ultrazohm/uz_a_max11331/Project Outputs for UZ_A_MAX11331/Rev03/DOC/UZ_A_MAX11331_3D_View_Bird_Rev03.png

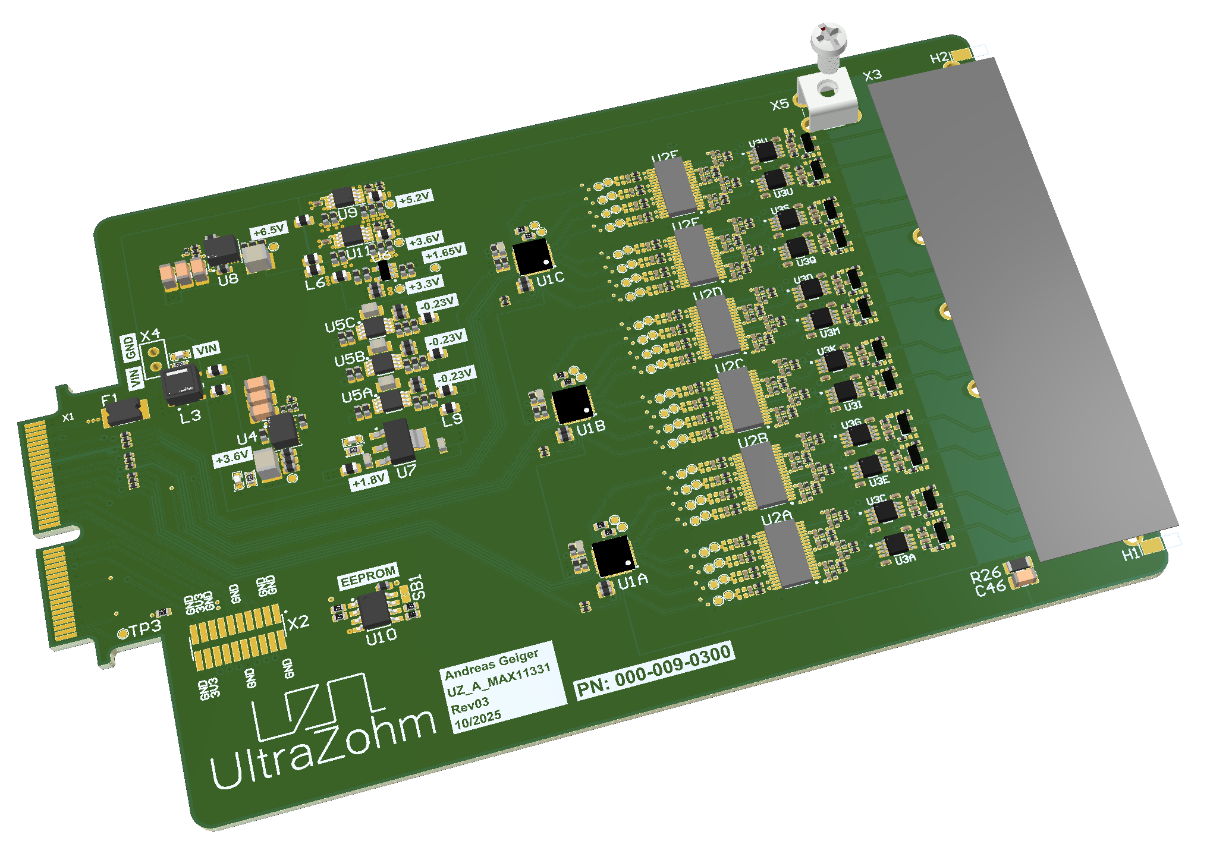
Project Outputs for UZ_A_MAX11331/Rev03/DOC/UZ_A_MAX11331_3D_View_Bird_Rev03.png
