ultrazohm/uz_a_max11331/Work_LTspice/Boost_and_Diff_OpAmp/MAX11331_Rev03_OpAmp_SupplyCurrentSimulation.png

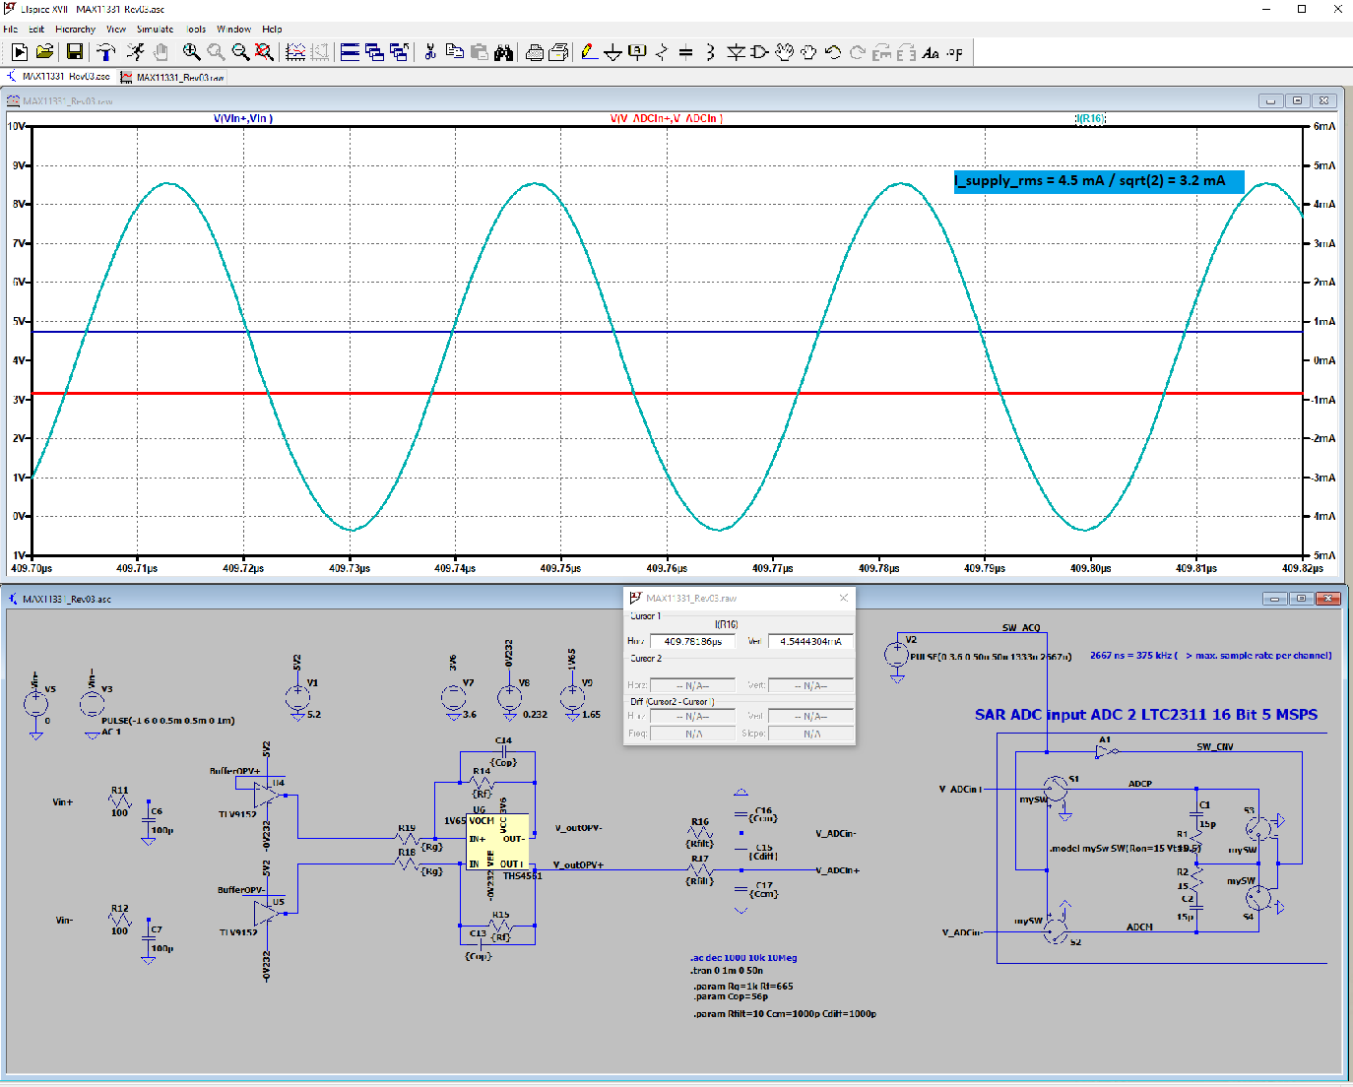
Work_LTspice/Boost_and_Diff_OpAmp/MAX11331_Rev03_OpAmp_SupplyCurrentSimulation.png
