ultrazohm/uz_a_max11331/Project Outputs for UZ_A_MAX11331/Rev03/MAX1131_V3_Evaluation.xlsx

MAX11 V3 ADC Evaluation (Alle Messungen in [V]) |  |  |  | ConversionFactor ADC auf Basis von OpAMp Schaltung im Analog-FrondEnd:
 |  |  |  |  | 4.962406015
 |  |  |  | Nutzbarer Spannungsbereich (alles was größer ist im Betrag, wird nicht mehr gemessen)
 |  |  |  |  | -4,957V…+4,957V
 |  |  |  |  |  | [V] |  |  | [A] | [A] | [A]
Extern _P | Extern _N | Extern Delta | ADC01 | ADC09 | ADC17 | Fehler von ADC01 | Fehler von ADC09 | Fehler von ADC17 | ADC01:Wenn 5V=600A wären | ADC09:Wenn 5V=600A wären | ADC17:Wenn 5V=600A wären
0 | 4.955 | -4.955 | -4.957 | -4.959987 | -4.96241 | 0.002 | 0.004987 | 0.00741 | 0.24 | 0.60 | 0.89
0 | 4.755 | -4.755 | -4.761 | -4.758873 | -4.76372 | 0.006 | 0.003873 | 0.00872 | 0.72 | 0.46 | 1.05
0 | 4.455 | -4.455 | -4.458 | -4.455992 | -4.463261 | 0.003 | 0.000992 | 0.008261 | 0.36 | 0.12 | 0.99
0 | 4.055 | -4.055 | -4.061 | -4.056189 | -4.061035 | 0.006 | 0.001189 | 0.006035 | 0.72 | 0.14 | 0.72
0 | 3.957 | -3.957 | -3.961 | -3.954421 | -3.964113 | 0.004 | -0.002579 | 0.007113 | 0.48 | -0.31 | 0.85
0 | 2.957 | -2.957 | -2.961 | -2.958546 | -2.960969 | 0.004 | 0.001546 | 0.003969 | 0.48 | 0.19 | 0.48
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
