ultrazohm/uz_a_max11331/Project Outputs for UZ_A_MAX11331/Rev01/ASM_UZ_A_MAX11331_Differential_Input_Rev01.PDF

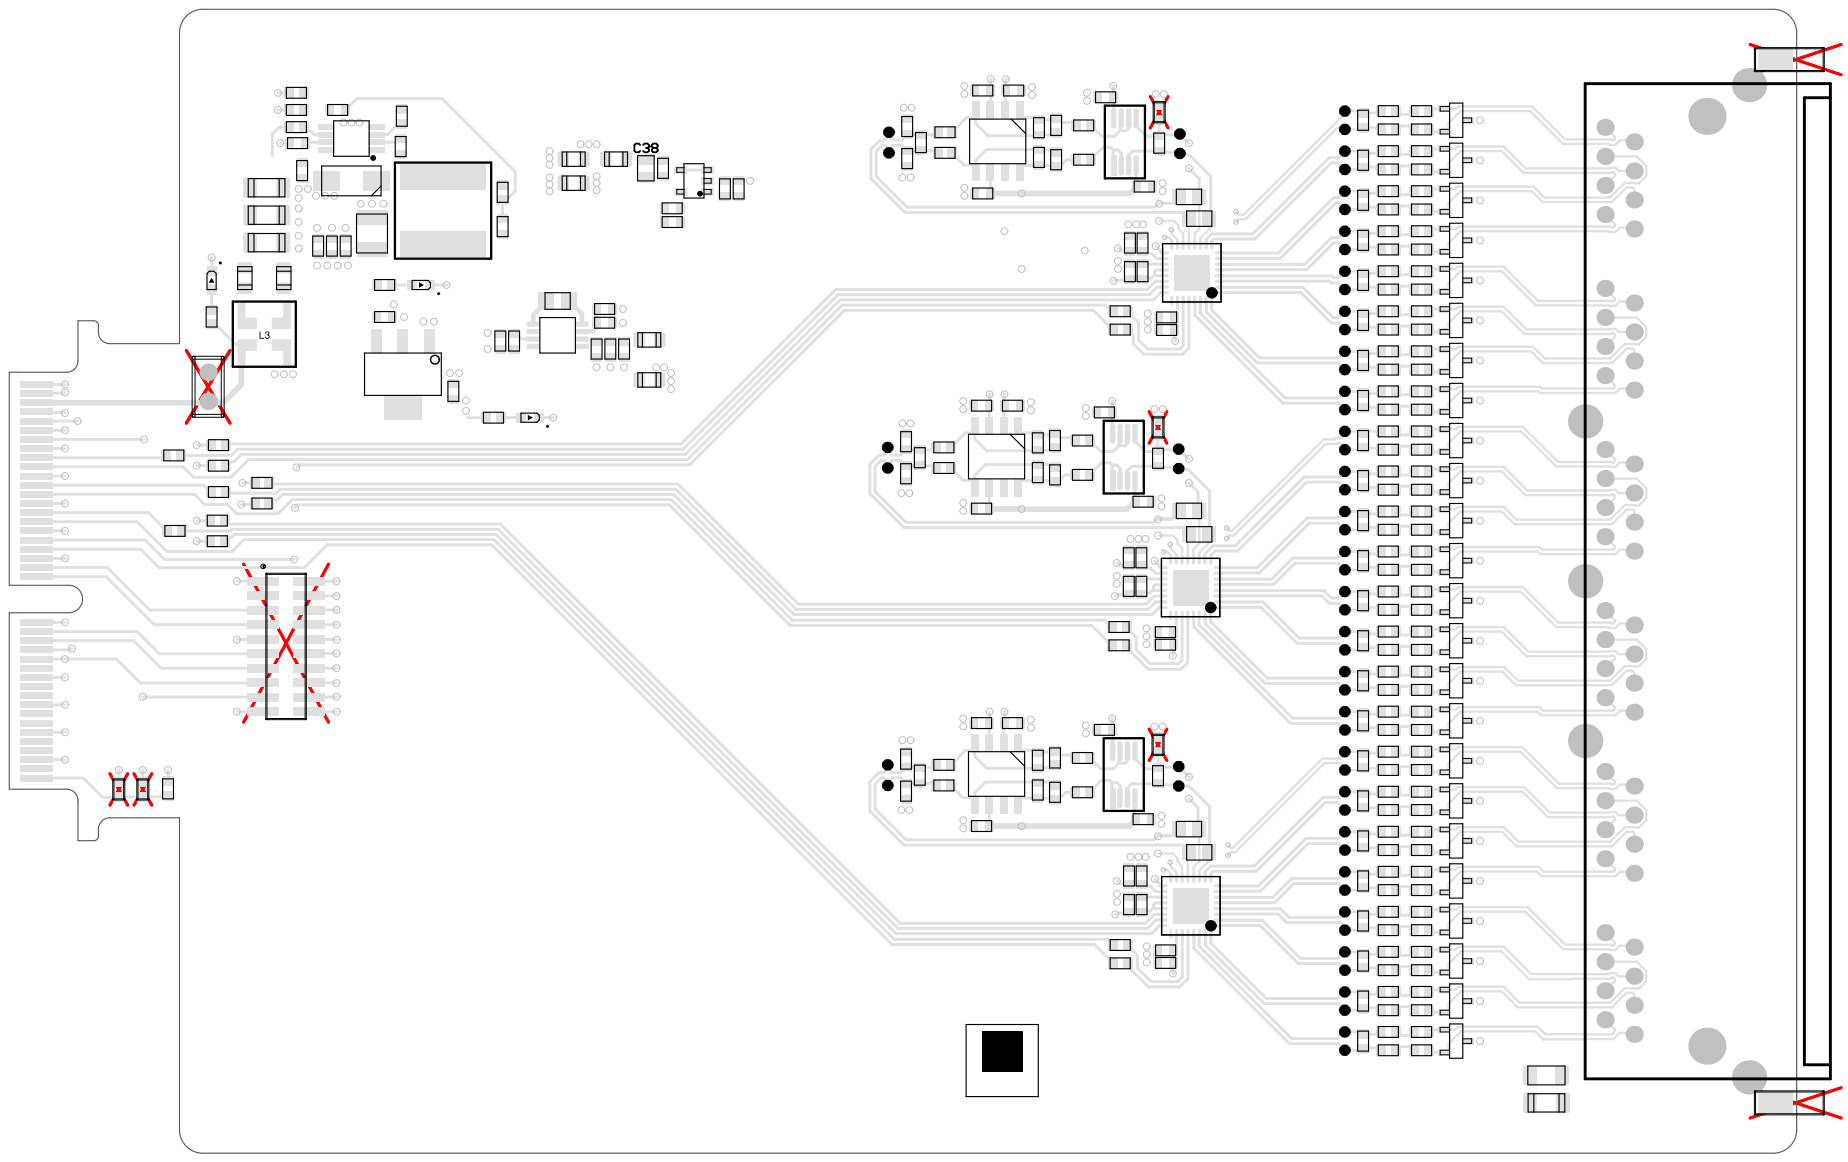
[picture p5: page 1]

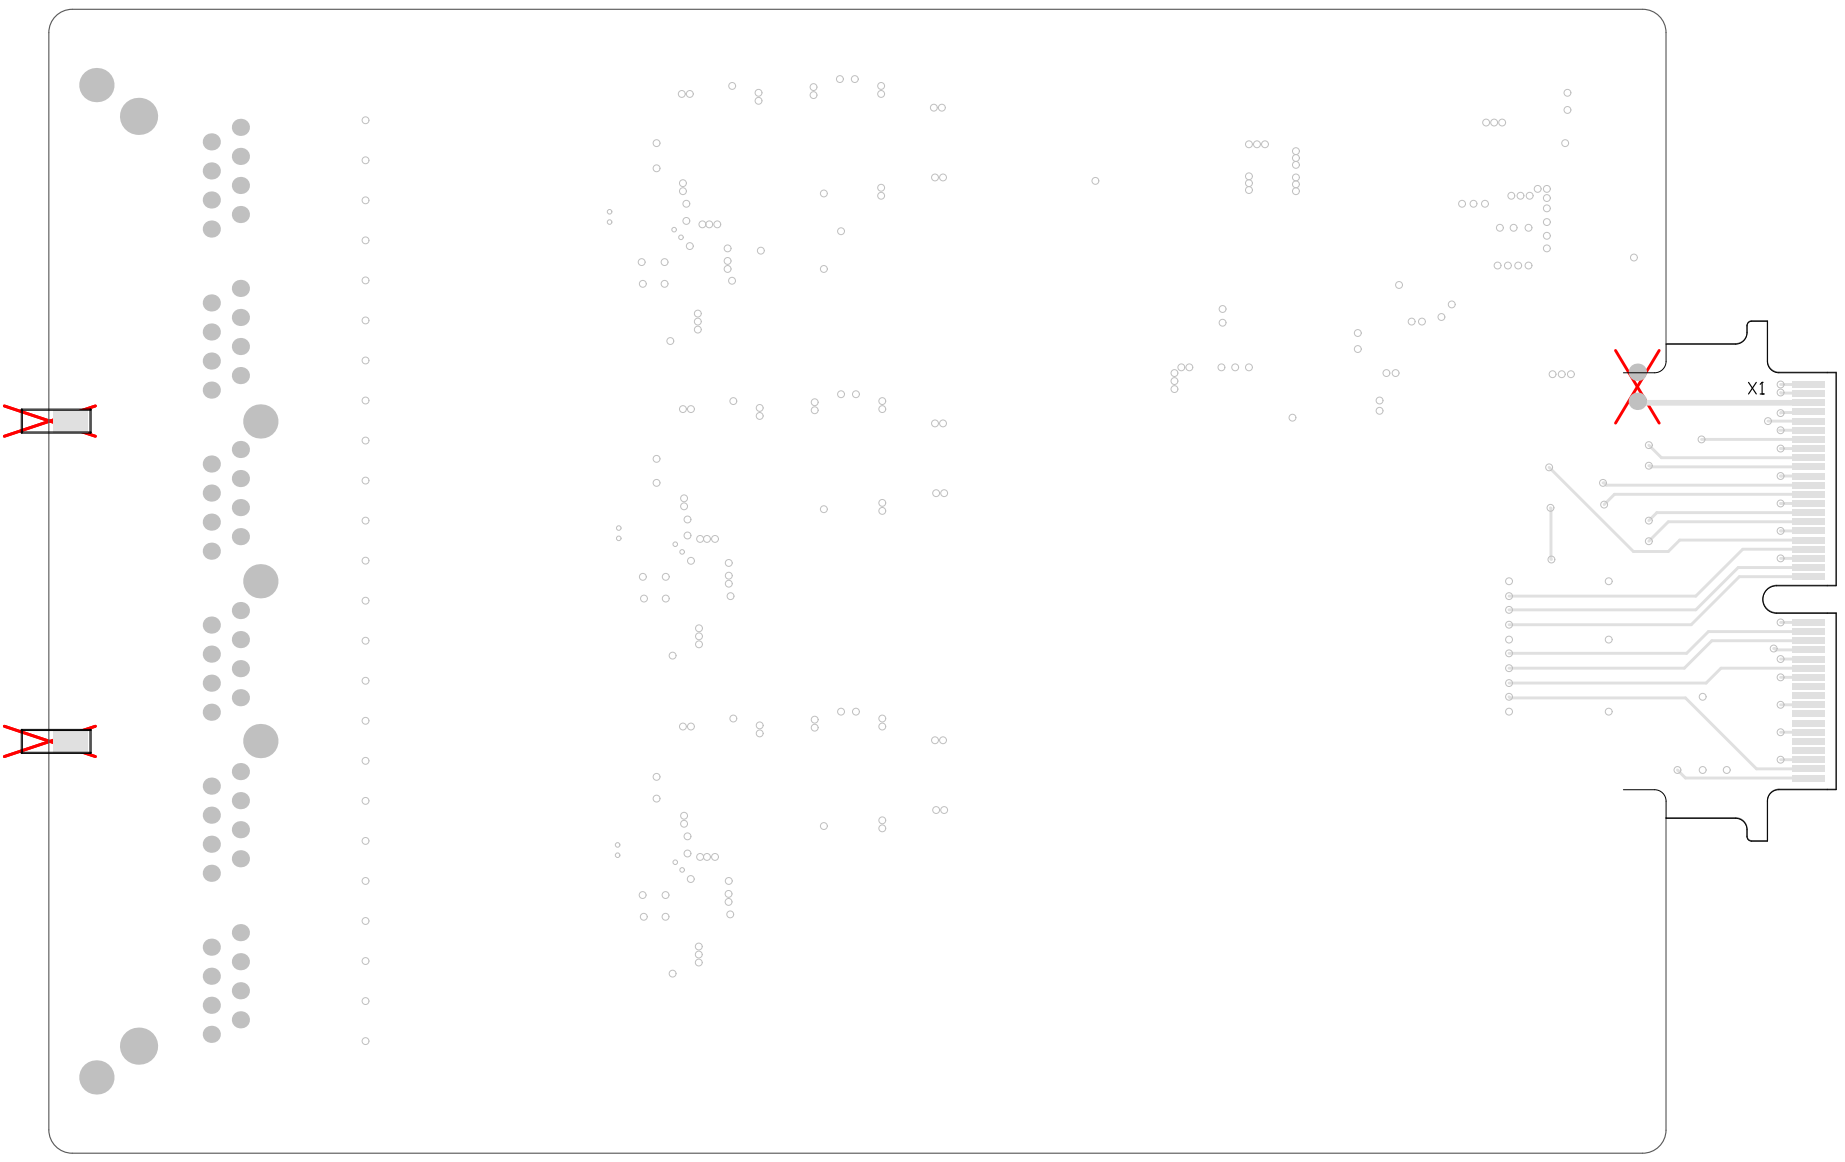
[picture p6: page 2]
