ultrazohm/uz_a_max11331/Project Outputs for UZ_A_MAX11331/Rev02/DOC/UZ_A_MAX11331_3D_View_Bird_Rev02.PDF

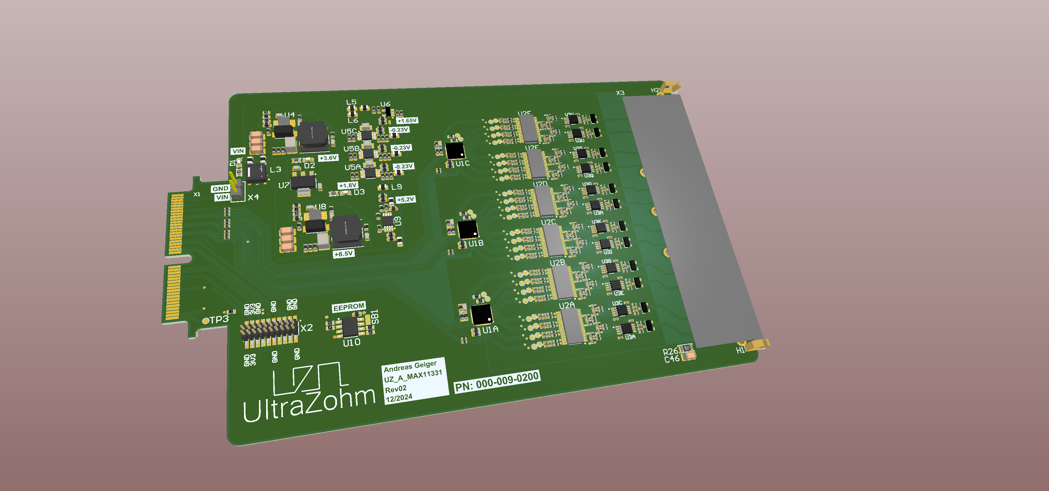
[picture p7: page 1]
