ultrazohm/uz_a_max11331/Project Outputs for UZ_A_MAX11331/Rev02/DOC/UZ_A_MAX11331_3D_View_Bot_Rev02.PDF

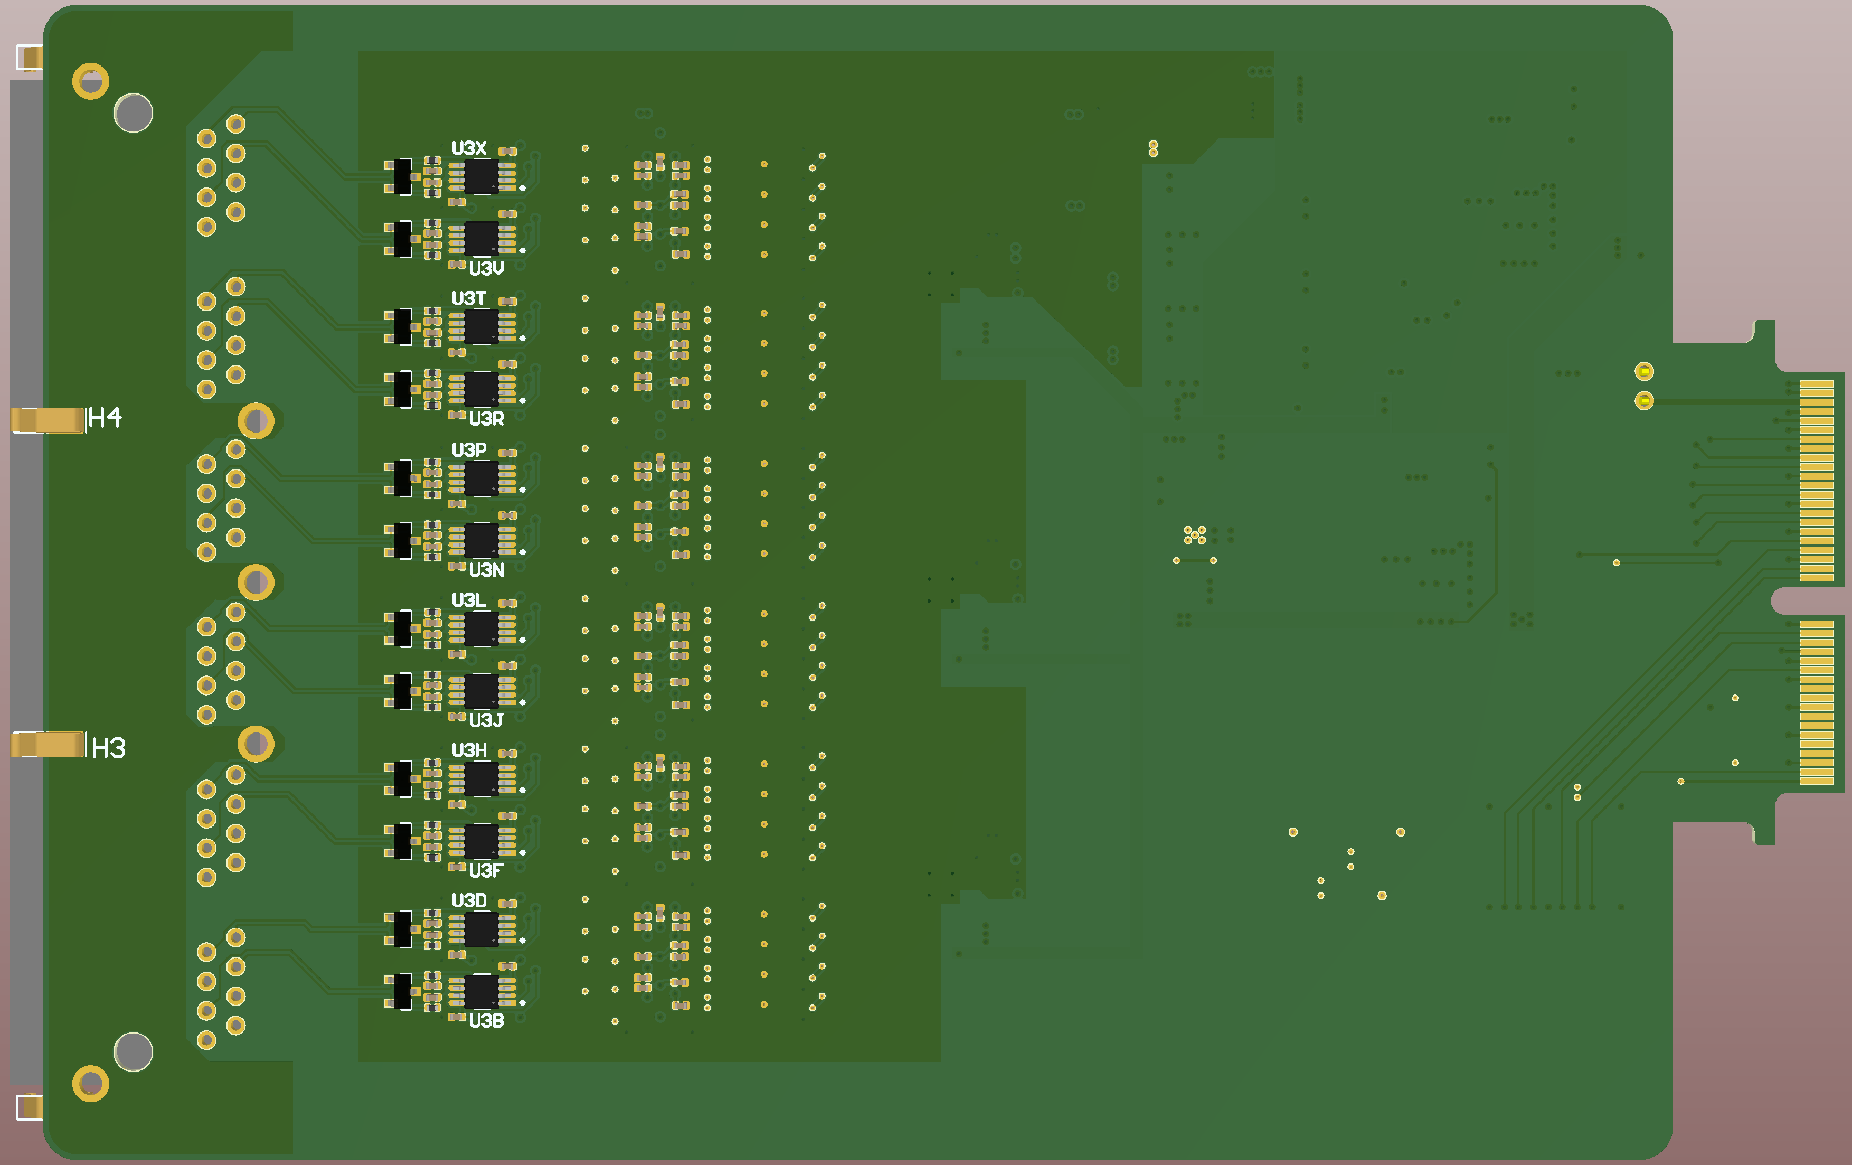
[picture p8: page 1]
