ultrazohm/uz_a_max11331/Project Outputs for UZ_A_MAX11331/Rev02/DOC/UZ_A_MAX11331_3D_View_Top_Rev02.PDF

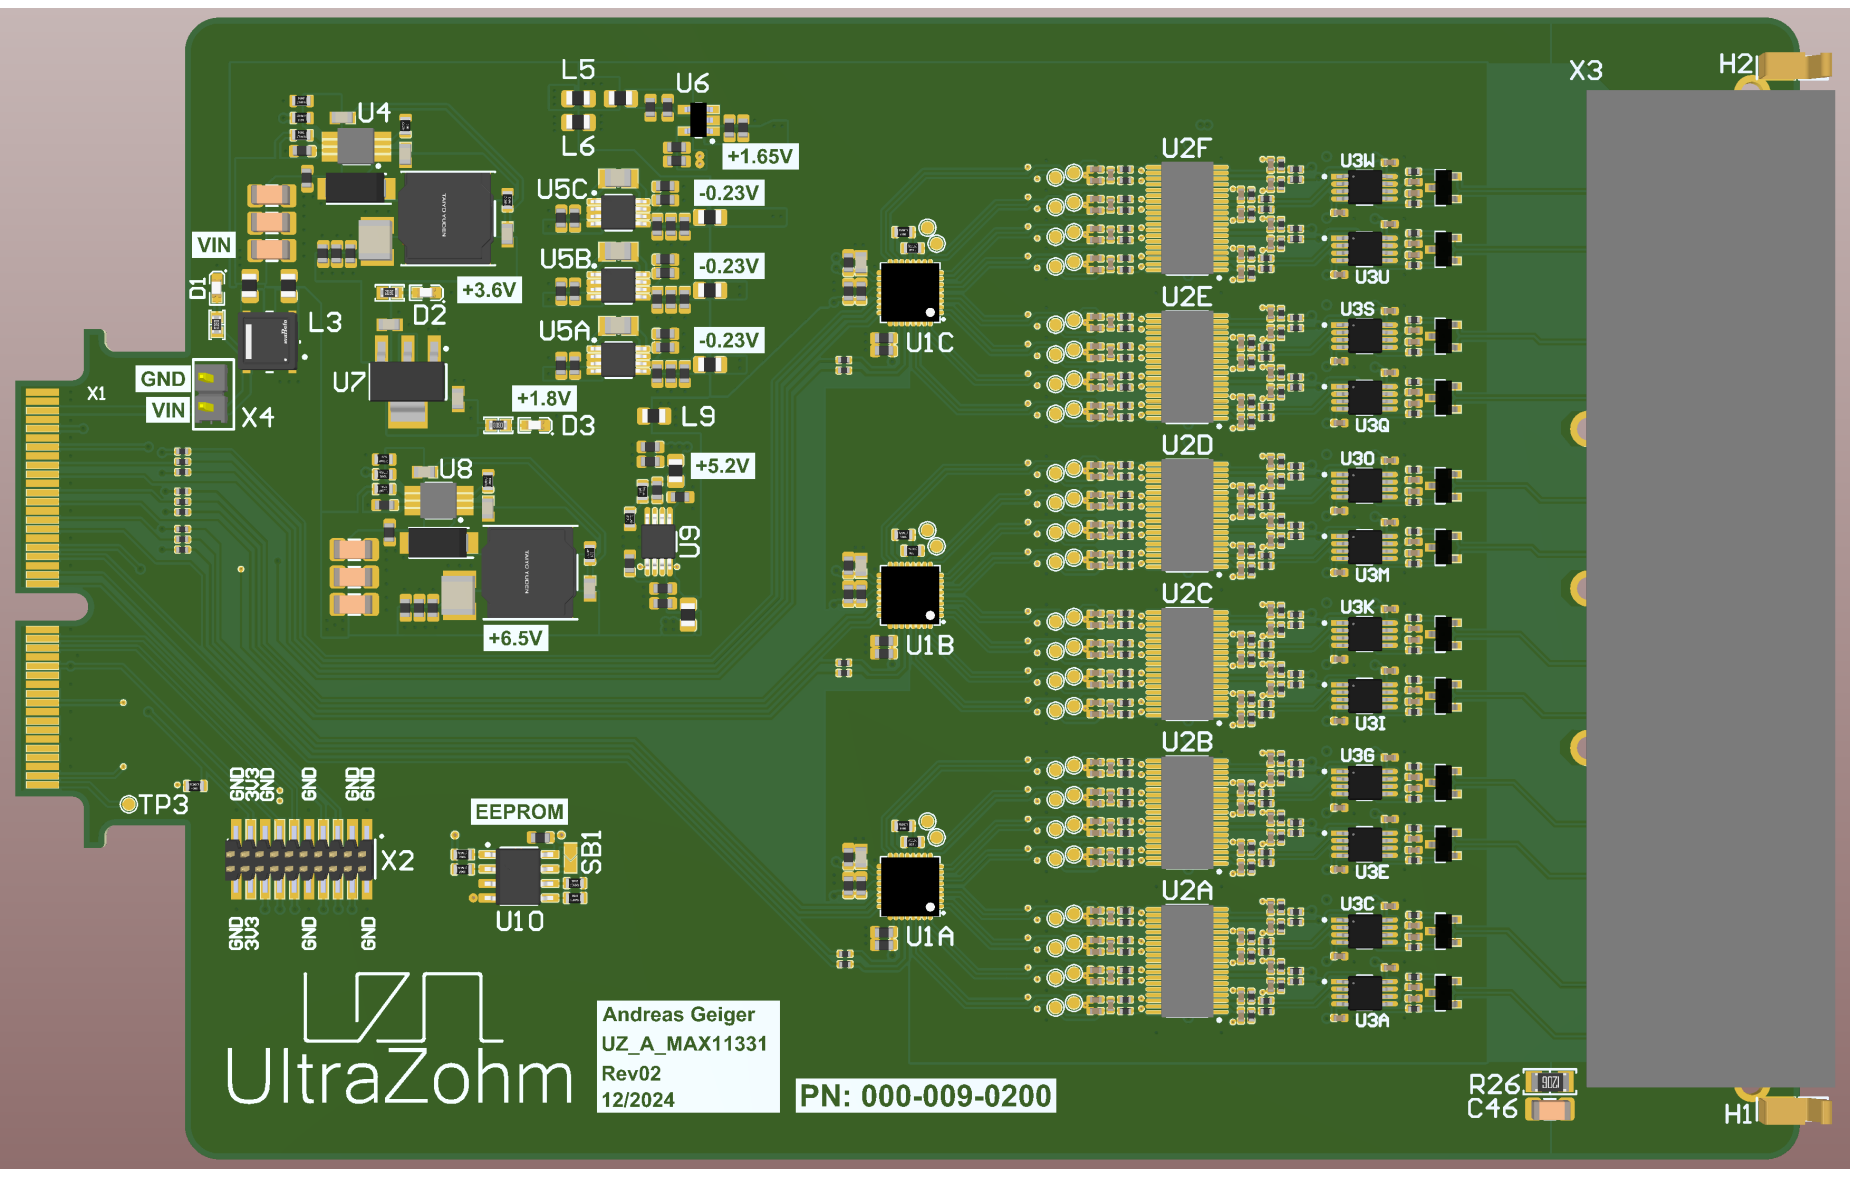
[picture p9: page 1]
