ultrazohm/uz_a_max11331/Work_LTspice/Boost_and_Diff_OpAmp/MAX11331_Rev03.asc

A1: inv
C1: cap; 15p
C2: cap; 15p
C6: cap; 100p
C7: cap; 100p
C13: cap; {Cop}
C14: cap; {Cop}
C15: cap; {Cdiff}
C16: cap; {Ccm}
C17: cap; {Ccm}
R1: res; 15
R2: res; 15
R11: res; 100
R12: res; 100
R14: res; {Rf}
R15: res; {Rf}
R16: res; {Rfilt}
R17: res; {Rfilt}
R18: res; {Rg}
R19: res; {Rg}
S1: sw; mySW
S2: sw; mySW
S3: sw; mySW
S4: sw; mySW
U4: TLV9152
U5: TLV9152
U6: THS4561
V1: voltage; 5.2
V2: voltage; PULSE(0 3.6 0 50n 50n 1333n 2667n)
V3: voltage; PULSE(-1 6 0 0.5m 0.5m 0 1m); AC 1
V5: voltage; 0
V7: voltage; 3.6
V8: voltage; -0.232
V9: voltage; 1.65
Named nets: 0, Vin+, Vin-, 3V6, -0V232, 5V2, V_outOPV+, V_outOPV-, 1V65, BufferOPV-, BufferOPV+, SW_ACQ, ADCP, ADCM, SW_CNV, V_ADCin+, V_ADCin-
.tran 0 1m 0 50n
.param Rg=1k Rf=665
.param Cop=56p
.ac dec 1000 10k 10Meg
.param Rfilt=10 Ccm=1000p Cdiff=1000p
.model mySw SW(Ron=15 Vt=0.5)
SAR ADC input ADC 2 LTC2311 16 Bit 5 MSPS
2667 ns = 375 kHz (--> max. sample rate per channel)
