ultrazohm/uz_a_max11331/Work_LTspice/AnalogLTC2311-16_with_THS4521/ADC_ShuntSensitec_MitSpannungsfolgerV4_DiffAmpTHS4521_ADC-Driver_LTC2311_16Bit5MSPS_ohneADC.asc

C1: cap; 100p
C2: cap; 100p
C3: cap; 10µ
C4: cap; .01µ
C5: cap; 10µ
C6: cap; .01µ
C7: cap; 470p
C8: cap; 680p
C9: cap; 680p
C10: cap; 56p
C11: cap; 56p
I1: current; SINE(0 0.003 50k)
R1: res; {Rfilt}
R2: res; 820
R3: res; {Rfilt}
R4: res; {Rfilt}
R5: res; 24.9
R6: res; 24.9
R7: res; {Rfilt}
U1: LT1763-5
U2: LT6204
U3: LT6204
U4: LT1761-2.5
U5: THS4521
V2: voltage; 9
V3: voltage; 9
V4: voltage; 2
V5: voltage; PWL(5u 2 10u 2.4 15u 2.4 20u 2.5 25u 2.5 30u -2 35u -2 40u -2.5)
V6: voltage; 0
V8: voltage; -5
V9: voltage; PWL(5u 0 10u 3 15u 3 20u 4.5 25u 4.5 30u 4.75 35u 4.75 40u 5)
V10: voltage; SINE(2.5 0 50k); AC 1V
V11: voltage; 2.5
Named nets: 0, 5V, 2.5V, V_outADCdriver, V_outADCdriverInv, V_ADCin+, V_ADCin-, -Vs, Buffer+, Vin+, Vin-, Buffer-
.tran 0 0.00005 0
.ac dec 1000 1k 10Meg
Simulierte Ausgangsspannung
Stromsensor von 0-5V
.param Rfilt=10k
