ultrazohm/uz_a_max11331/(list of files, drawings)

Other design files:
ADC_Signal_Distribution.SchDoc
Analog_Frontend_OpAmp.SchDoc
AnalogConnector.SchDoc
Block_Diagram.SchDoc
BufferOpAmp.SchDoc
CarrierConnector.SchDoc
CM_DM_Filter.SchDoc
Multiplexed_ADC.SchDoc
Power_Supply_1.SchDoc
Power_Supply_2.SchDoc
Power_Supply_3.SchDoc
TopSheet.SchDoc
UZ_A_MAX11331.PcbDoc
UZ_A_MAX11331.PrjPCB
