ultrazohm/uz_a_max11331/(commit log)

2022-08-22 overtake design files from other repo to this
    [AnalogConnector.SchDoc, CarrierConnector.SchDoc, Multiplexed_ADC.SchDoc, TopSheet.SchDoc, UZ_A_MAX11331.PcbDoc, UZ_A_MAX11331.PrjPCB]
2022-08-22 added new 10 uF cap from JLCPCB lib
    [Multiplexed_ADC.SchDoc]
2022-08-22 added new 100 nF cap from JLCPCB lib
    [Multiplexed_ADC.SchDoc]
2022-08-22 added new 470 nF cap from JLCPCB lib
    [Multiplexed_ADC.SchDoc]
2022-08-29 block diagram with analog pinout planning
    [Block_Diagram.SchDoc]
2022-08-29 change MAX11 to JLC lib compatible parts
    [AnalogConnector.SchDoc, Multiplexed_ADC.SchDoc, UZ_A_MAX11331.PcbDoc]
2022-08-30 add analog input signal protection
    [ADC_Reference_Voltage.SchDoc, AnalogConnector.SchDoc, Analog_Input_Signal_Conditioning.SchDoc, Block_Diagram.SchDoc, CarrierConnector.SchDoc, Multiplexed_ADC.SchDoc, TopSheet.SchDoc, UZ_A_MAX11331.PrjPCB]
2022-08-30 increase analog input bus
    [AnalogConnector.SchDoc, Block_Diagram.SchDoc, TopSheet.SchDoc]
2022-08-30 adopt hiearchal structure to multi-channel design
    [ADC_Signal_Distribution.SchDoc, CarrierConnector.SchDoc, Multiplexed_ADC.SchDoc, TopSheet.SchDoc, UZ_A_MAX11331.PrjPCB]
2022-08-30 analog inputs via 6x RJ45 connectors
    [ADC_Signal_Distribution.SchDoc, AnalogConnector.SchDoc]
2022-09-01 insert voltage devider at analog input stage
    [Analog_Input_Signal_Conditioning.SchDoc, Multiplexed_ADC.SchDoc, UZ_A_MAX11331.PrjPCB]
2022-09-01 insert OpAmp to externen analog signal bypass at MAX11
    [ADC_Reference_Voltage.SchDoc, ADC_Signal_Distribution.SchDoc, AnalogConnector.SchDoc, Analog_Input_Signal_Conditioning.SchDoc, Multiplexed_ADC.SchDoc, OpAmp.SchDoc, TopSheet.SchDoc, UZ_A_MAX11331.PrjPCB]
2022-09-03 design anti aliasing filter for ADC input
    [ADC_Reference_Voltage.SchDoc, ADC_Signal_Distribution.SchDoc, AnalogConnector.SchDoc, Multiplexed_ADC.SchDoc, OpAmp.SchDoc, TopSheet.SchDoc, UZ_A_MAX11331.PrjPCB]
2022-09-03 new ferrite beat from JLC
    [ADC_Reference_Voltage.SchDoc, Multiplexed_ADC.SchDoc, OpAmp.SchDoc, TopSheet.SchDoc, UZ_A_MAX11331.PrjPCB]
2022-09-20 insert 6x RJ45 connector
    [ADC_Reference_Voltage.SchDoc, ADC_Signal_Distribution.SchDoc, AnalogConnector.SchDoc, Analog_Input_Signal_Conditioning.SchDoc, Block_Diagram.SchDoc, CarrierConnector.SchDoc, Multiplexed_ADC.SchDoc, OpAmp.SchDoc]
2022-09-20 use Testpoint from DbLib
    [ADC_Reference_Voltage.SchDoc, Analog_Input_Signal_Conditioning.SchDoc, CarrierConnector.SchDoc, Multiplexed_ADC.SchDoc, OpAmp.SchDoc, UZ_A_MAX11331.PrjPCB]
2022-09-20 Connect SP signalsI to UZ-Connector
    [ADC_Signal_Distribution.SchDoc, CarrierConnector.SchDoc, Multiplexed_ADC.SchDoc, TopSheet.SchDoc, UZ_A_MAX11331.PrjPCB]
2022-09-20 create schematic for DCDC converter
    [ADC_Reference_Voltage.SchDoc, Power_Supply.SchDoc, TopSheet.SchDoc, UZ_A_MAX11331.PrjPCB]
2022-09-21 new DCDC design of LM5007 with power inductor available at JLCPCB
    [Power_Supply.SchDoc, TopSheet.SchDoc]
2022-09-21 add large output capacitance to DC/DC converter
    [Power_Supply.SchDoc]
2022-09-29 add connector for unused signals of carrier connector for debugging purposes
    [AnalogConnector.SchDoc, CarrierConnector.SchDoc, OpAmp.SchDoc, Power_Supply.SchDoc, TopSheet.SchDoc]
2022-10-17 Adopt supply of ADC
    [AnalogConnector.SchDoc, Block_Diagram.SchDoc, CarrierConnector.SchDoc, Multiplexed_ADC.SchDoc, OpAmp.SchDoc, Power_Supply.SchDoc, TopSheet.SchDoc, UZ_A_MAX11331.PrjPCB]
2022-10-18 configure rooms
    [TopSheet.SchDoc]
2022-10-18 edge room component clearance setting
    [Analog_Input_Signal_Conditioning.SchDoc, TopSheet.SchDoc]
2022-10-18 place ADC and OpAmp components
    [Power_Supply.SchDoc, UZ_A_MAX11331.PrjPCB]
2022-10-18 overall placement
    [Analog_Input_Signal_Conditioning.SchDoc, OpAmp.SchDoc, Power_Supply.SchDoc, TopSheet.SchDoc, UZ_A_MAX11331.PrjPCB]
2022-10-18 add common mode choke to DCDC power supply
    [Power_Supply.SchDoc]
2022-10-27 change analog input range from -5V ... +5V to 0V ... +5V
    [Analog_Input_Signal_Conditioning.SchDoc, UZ_A_MAX11331.PrjPCB]
2022-11-20 LM7705 inserted for negative supply of Opamps
    [Block_Diagram.SchDoc, CarrierConnector.SchDoc, OpAmp.SchDoc, Power_Supply.SchDoc, TopSheet.SchDoc, UZ_A_MAX11331.PrjPCB]
2022-11-24 insert LM7705
    [AnalogConnector.SchDoc, Block_Diagram.SchDoc, Multiplexed_ADC.SchDoc, OpAmp.SchDoc, Power_Supply.SchDoc, UZ_A_MAX11331.PrjPCB]
2022-11-24 attach analog input signal protection TVS to AGND instead of GND net
    [Analog_Input_Signal_Conditioning.SchDoc, OpAmp.SchDoc, Power_Supply.SchDoc]
2022-11-24 SPI routing
    [CarrierConnector.SchDoc, UZ_A_MAX11331.PrjPCB]
2022-11-28 change P and N at Diff-Opamp output
    [OpAmp.SchDoc]
2022-11-28 DCDC routing
    [Multiplexed_ADC.SchDoc, Power_Supply.SchDoc, TopSheet.SchDoc, UZ_A_MAX11331.PrjPCB]
2022-11-28 change digital power supply of MAX11 from 3.6V to 1.8V
    [CarrierConnector.SchDoc, Multiplexed_ADC.SchDoc, OpAmp.SchDoc, Power_Supply.SchDoc, TopSheet.SchDoc]
2022-11-28 place power supply planes
    [OpAmp.SchDoc]
2022-11-28 Modify GND plane as EMC shield
2022-11-29 optimize GND polygon on toplayer
2022-11-29 New routing of SPI lines, analog input interface and analog lines between MAX11 and Opamp due to wrong Design Rules Template
    [Multiplexed_ADC.SchDoc]
2022-11-29 Define EdgeConnector as "Standard (No BOM)" part
    [CarrierConnector.SchDoc, UZ_A_MAX11331.PrjPCB]
2022-11-29 update R3 and C38 parameter from database
    [Power_Supply.SchDoc, TopSheet.SchDoc, UZ_A_MAX11331.PrjPCB]
2022-11-29 update D5 parameter from database
    [Power_Supply.SchDoc, UZ_A_MAX11331.PrjPCB]
2022-11-30 update output job to include jlc assembly files
2022-12-01 fix jlc bom
2022-12-02 add frame ground to RJ45 to separate from PCB ground
    [AnalogConnector.SchDoc]
2022-12-02 single-ended termination resistors implemented
    [ADC_Signal_Distribution.SchDoc, AnalogConnector.SchDoc, Block_Diagram.SchDoc, CarrierConnector.SchDoc, Multiplexed_ADC.SchDoc, Power_Supply.SchDoc, TopSheet.SchDoc, UZ_A_MAX11331.PrjPCB]
2022-12-02 differential analog input signals routed to new RJ45 position
    [UZ_A_MAX11331.PrjPCB]
2022-12-02 configure all Vias to tented Vias
    [Block_Diagram.SchDoc]
2022-12-02 2-pin header for power supply input inserted for test purposes
    [Power_Supply.SchDoc]
2022-12-02 set power supply connector as DNP
    [Power_Supply.SchDoc, UZ_A_MAX11331.PrjPCB]
2022-12-02 DRC run without errors
    [UZ_A_MAX11331.PrjPCB]
2022-12-07 create Assembly Drawing
    [BOM_JLC-UZ_A_MAX11331(Differential_Input).xlsx, PickPlace_UZ_A_MAX11331_Rev01.csv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]
2023-03-16 adapt DNP marker for R7 and R8
    [UZ_A_MAX11331.PrjPCB]
2024-07-29 insert differential OpAmp stage
    [DiffOpAmp.SchDoc, UZ_A_MAX11331.PrjPCB]
2024-07-30 remove 100 nF capacitor in bypass path
    [OpAmp.SchDoc]
2024-11-15 change analog frontend to OpAmp
    [Analog_Frontend_OpAmp.SchDoc, Analog_Input_Signal_Conditioning.SchDoc, UZ_A_MAX11331.PrjPCB]
2024-11-18 insert sheet entrys on topsheet
    [Analog_Frontend_OpAmp.SchDoc, TopSheet.SchDoc]
2024-11-18 insert quad-channel DiffOpAmp
    [Analog_Frontend_OpAmp.SchDoc, DiffOpAmp.SchDoc]
2024-11-18 move buffer OpAmp to separate sub-sheet
    [BufferOpAmp.SchDoc, DiffOpAmp.SchDoc]
2024-11-18 add CM and DM filter schematic
    [CM_DM_Filter.SchDoc]
2024-11-18 remove variant "single-ended analog input"; set DNP in variant to use buffer OpAmp
    [Analog_Frontend_OpAmp.SchDoc, BufferOpAmp.SchDoc, CM_DM_Filter.SchDoc, Multiplexed_ADC.SchDoc, UZ_A_MAX11331.PrjPCB]
2024-11-18 place parts around quad OpAmp
    [Analog_Frontend_OpAmp.SchDoc, Multiplexed_ADC.SchDoc, UZ_A_MAX11331.PrjPCB]
2024-11-18 place Assembly designators
    [CM_DM_Filter.SchDoc]
2024-11-18 arrange analog frontend rooms
    [TopSheet.SchDoc]
2024-11-18 rename power supply schematic
    [Power_Supply_1.SchDoc]
2024-11-18 insert +6.5V and +5.2V power supply
    [Analog_Frontend_OpAmp.SchDoc, BufferOpAmp.SchDoc, Multiplexed_ADC.SchDoc, Power_Supply_1.SchDoc, Power_Supply_2.SchDoc, TopSheet.SchDoc, UZ_A_MAX11331.PrjPCB]
2024-11-19 adapt block diagram
    [Analog_Frontend_OpAmp.SchDoc, Block_Diagram.SchDoc]
2024-11-19 move MAX11 to middle of PCB; insert testpoints at bypass of MAX11
    [Multiplexed_ADC.SchDoc, TopSheet.SchDoc, UZ_A_MAX11331.PrjPCB]
2024-11-20 remove shunt resistor (current measurement mode) from buffer OpAmp
    [BufferOpAmp.SchDoc, Multiplexed_ADC.SchDoc, Power_Supply_1.SchDoc, Power_Supply_2.SchDoc, UZ_A_MAX11331.PrjPCB]
2024-11-21 place analog frontend on PCB
2024-11-21 placement of +6.5V DCDC
2024-11-21 placement of +5.2V DCDC
    [Multiplexed_ADC.SchDoc, Power_Supply_1.SchDoc, TopSheet.SchDoc, UZ_A_MAX11331.PrjPCB]
2024-11-21 increase from 4-layer to 6-layer stackup (by loading JLC_6_layer_1.6mm.stackup file)
2024-11-26 routing of power supply
    [Multiplexed_ADC.SchDoc, Power_Supply_1.SchDoc, Power_Supply_2.SchDoc, UZ_A_MAX11331.PrjPCB]
2024-11-29 routing of anti-alias filter
2024-11-29 routing of power polygons
2024-12-03 correct board outline
2024-12-09 add EEPROM
    [CarrierConnector.SchDoc]
2024-12-09 set CM-Filter to DNP; set DM-Filter to 156 kHz
    [CM_DM_Filter.SchDoc, UZ_A_MAX11331.PrjPCB]
2024-12-10 reduce input filter at buffer OpAmp from 15.9 MHz to 1.06 MHz
    [BufferOpAmp.SchDoc]
2024-12-10 placing of EEPROM
    [CarrierConnector.SchDoc, UZ_A_MAX11331.PrjPCB]
2024-12-10 insert 3x -0.23V power supply
    [Analog_Frontend_OpAmp.SchDoc, BufferOpAmp.SchDoc, Power_Supply_2.SchDoc, Power_Supply_3.SchDoc, TopSheet.SchDoc, UZ_A_MAX11331.PrjPCB]
2024-12-10 routing of -0.23V power supply
    [Analog_Frontend_OpAmp.SchDoc, TopSheet.SchDoc]
2024-12-10 finish routing
    [CarrierConnector.SchDoc, UZ_A_MAX11331.PrjPCB]
2024-12-10 sheet numbering
    [ADC_Signal_Distribution.SchDoc, Analog_Frontend_OpAmp.SchDoc, Block_Diagram.SchDoc, BufferOpAmp.SchDoc, CM_DM_Filter.SchDoc, Multiplexed_ADC.SchDoc, Power_Supply_1.SchDoc, Power_Supply_2.SchDoc]
2024-12-11 replace feedback gain resistors of Diff-OpAmp from 1k / 665R to 10k / 6k65 (decrease power consumption of OpAmp)
    [Analog_Frontend_OpAmp.SchDoc, UZ_A_MAX11331.PrjPCB]
2024-12-11 update sheet numbering
    [ADC_Signal_Distribution.SchDoc, AnalogConnector.SchDoc, Analog_Frontend_OpAmp.SchDoc, Block_Diagram.SchDoc, BufferOpAmp.SchDoc, CM_DM_Filter.SchDoc, CarrierConnector.SchDoc, Multiplexed_ADC.SchDoc]
2024-12-13 change small caps from X7R to NP0
    [Analog_Frontend_OpAmp.SchDoc, BufferOpAmp.SchDoc, CM_DM_Filter.SchDoc, UZ_A_MAX11331.PrjPCB]
2024-12-13 Rev02 production files as ordered on 13Dez2024
    [BOM_JLC-UZ_A_MAX11331(Differential_Input)-UZgenPartsMap.csv, BOM_JLC-UZ_A_MAX11331(Differential_Input)-UZgenResolved.csv, BOM_JLC-UZ_A_MAX11331(Differential_Input).csv, BOM_JLC-UZ_A_MAX11331(Differential_Input)_13Dez2024.xlsx, Pick Place for UZ_A_MAX11331(Differential_Input).csv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]
2024-12-13 update block diagram
    [Block_Diagram.SchDoc]
2024-12-16 change BOM for D5,D6 due to JLC production issue
    [BOM_JLC-UZ_A_MAX11331(Differential_Input)_13Dez2024.xlsx]
2025-02-18 modify system overview schematic page; add documentation
    [ADC_Signal_Distribution.SchDoc, AnalogConnector.SchDoc, Analog_Frontend_OpAmp.SchDoc, Block_Diagram.SchDoc, BufferOpAmp.SchDoc, CM_DM_Filter.SchDoc, CarrierConnector.SchDoc, Multiplexed_ADC.SchDoc]
2025-10-02 insert screw terminal for AGND
    [AnalogConnector.SchDoc]
2025-10-02 adapt polygons for screw terminal
    [Power_Supply_1.SchDoc]
2025-10-02 add 100k pull-downs at analog differential inputs
    [Analog_Frontend_OpAmp.SchDoc, BufferOpAmp.SchDoc, CM_DM_Filter.SchDoc, CarrierConnector.SchDoc, Multiplexed_ADC.SchDoc, UZ_A_MAX11331.PrjPCB]
2025-10-02 add fuse to VIN
    [CarrierConnector.SchDoc]
2025-10-02 change 1M to 0R resistor between FGND and GND
    [AnalogConnector.SchDoc, UZ_A_MAX11331.PrjPCB]
2025-10-07 add new DCDC for +6.5V and +3.6V; add power device tree diagram
    [Block_Diagram.SchDoc, Power_Supply_1.SchDoc, Power_Supply_2.SchDoc]
2025-10-07 set analog input frontend with pull-up on P and pull-down on N input
    [BufferOpAmp.SchDoc]
2025-10-07 add LDO for +3.6V
    [Block_Diagram.SchDoc, Power_Supply_1.SchDoc, Power_Supply_2.SchDoc, Power_Supply_3.SchDoc, UZ_A_MAX11331.PrjPCB]
2025-10-07 add LTspice simulation to simulate the supply current of the OpAmp
    [Power_Supply_2.SchDoc]
2025-10-07 routing of +1.8V LDO
    [Power_Supply_2.SchDoc, UZ_A_MAX11331.PrjPCB]
2025-10-07 placing of +3.6V and +6.5V DCDC
2025-10-07 change design rules (polygon connect style and clearances)
    [Power_Supply_1.SchDoc, Power_Supply_2.SchDoc]
2025-10-07 routing of all LDOs
    [Power_Supply_1.SchDoc]
2025-10-08 add pull-ups and pull-downs at all analog inputs; finish routing of PCB
    [BufferOpAmp.SchDoc, UZ_A_MAX11331.PrjPCB]
2025-10-08 uz_generic -> jlc map
    script update -> Rev03
    [BOM_JLC-UZ_A_MAX11331(Differential_Input)-UZgenPartsMap.csv, BOM_JLC-UZ_A_MAX11331(Differential_Input)-UZgenResolved.csv, BOM_JLC-UZ_A_MAX11331(Differential_Input).csv]
2025-10-09 udpate der jlc lib
    [BOM_JLC-UZ_A_MAX11331(Differential_Input)-UZgenPartsMap.csv, BOM_JLC-UZ_A_MAX11331(Differential_Input)-UZgenResolved.csv]
2025-10-09 tentative production files for Rev03
    [Pick Place for UZ_A_MAX11331(Differential_Input).csv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]
2025-10-09 add power consumption estimations; add ferrite beat to input of 1.8V LDO
    [Power_Supply_1.SchDoc, Power_Supply_2.SchDoc, UZ_A_MAX11331.PrjPCB]
2025-10-13 update block diagram with 3D picture; generate production files
    [BOM_JLC-UZ_A_MAX11331(Differential_Input).csv, Block_Diagram.SchDoc, Pick Place for UZ_A_MAX11331(Differential_Input).csv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]
2025-10-13 update resolved BoM
    [BOM_JLC-UZ_A_MAX11331(Differential_Input)-UZgenResolved.csv]
2025-10-14 run BOM mapping tool
    [BOM_JLC-UZ_A_MAX11331(Differential_Input)-UZgenResolved.csv]
2025-10-14 change R2 to UZgen part
    [TopSheet.SchDoc]
2025-10-14 save project file
    [UZ_A_MAX11331.PrjPCB]
2025-10-15 add BoM readme
2025-11-04 Added MAX1131_V3_Evaluation.xlsx für Inbetriebnahme
    [MAX1131_V3_Evaluation.xlsx]
